r2d5198/Taco12/taco12/readme.md

# Taco12

A Taco shaped 40% Keyboard.

Keyboard Maintainer: PsychicTaco13
Hardware Supported: Taco12 PCB
Hardware Availability: tacokb.com

Make example for this keyboard (after setting up your build environment):

    make taco12:default

See the [build environment setup](https://docs.qmk.fm/#/getting_started_build_tools) and the [make instructions](https://docs.qmk.fm/#/getting_started_make_guide) for more information. Brand new to QMK? Start with our [Complete Newbs Guide](https://docs.qmk.fm/#/newbs).
