r2d5198/Taco12/Taco12 (2).step

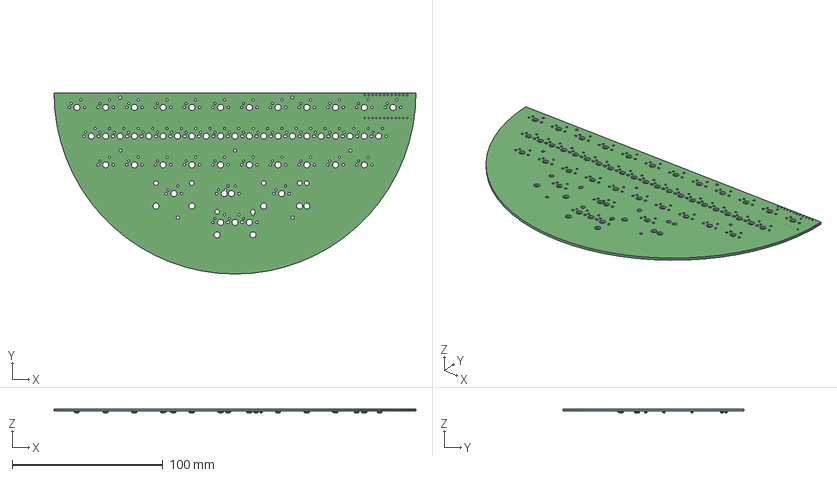
[picture p1: CAD file, 2020-12-30]
Taco12 (2).step
240.0 x 120.1 x 2.90 mm
